brett-daley/Project-Amp/Images/Printed_Circuit_Board.jpg

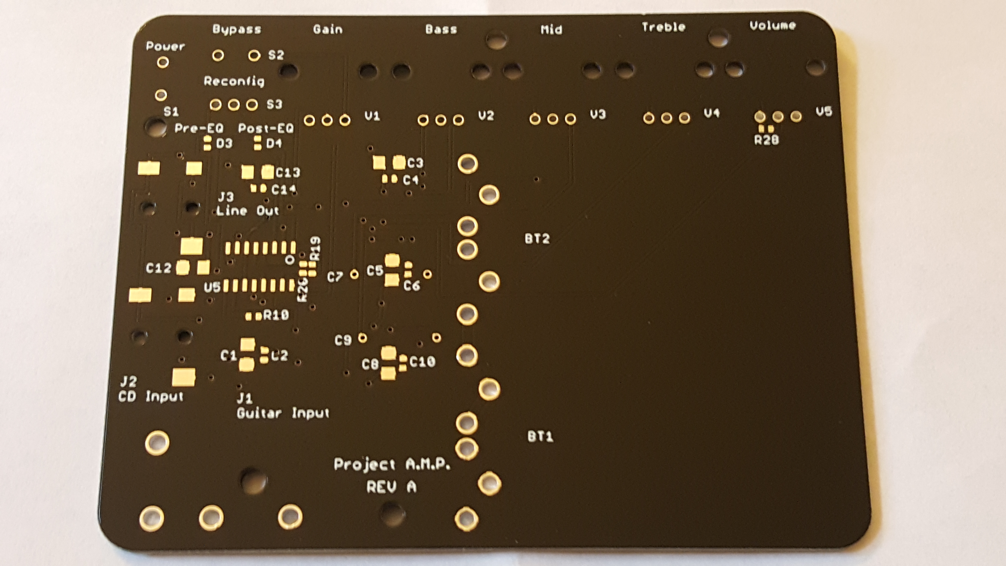
Images/Printed_Circuit_Board.jpg
