brett-daley/Project-Amp/Images/PCB_Assembly.png

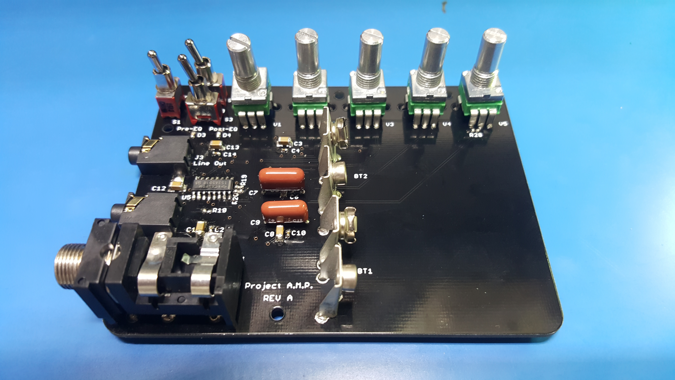
Images/PCB_Assembly.png
