brett-daley/Project-Amp/README.md

# Project-Amp
Small, portable headphone amplifier for the guitar. Complete with EQ and distortion.
