brett-daley/Project-Amp/Images/Layout_Bottom.png

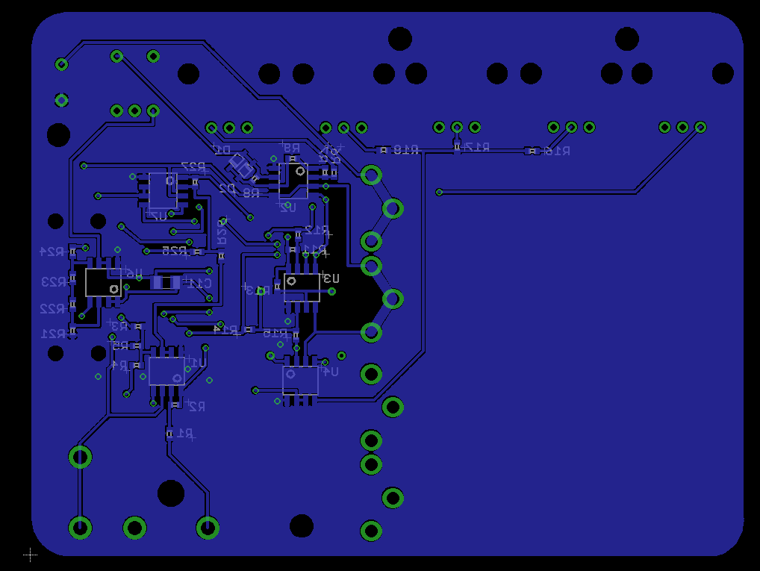
Images/Layout_Bottom.png
