brett-daley/Project-Amp/Images/Layout_Top.png

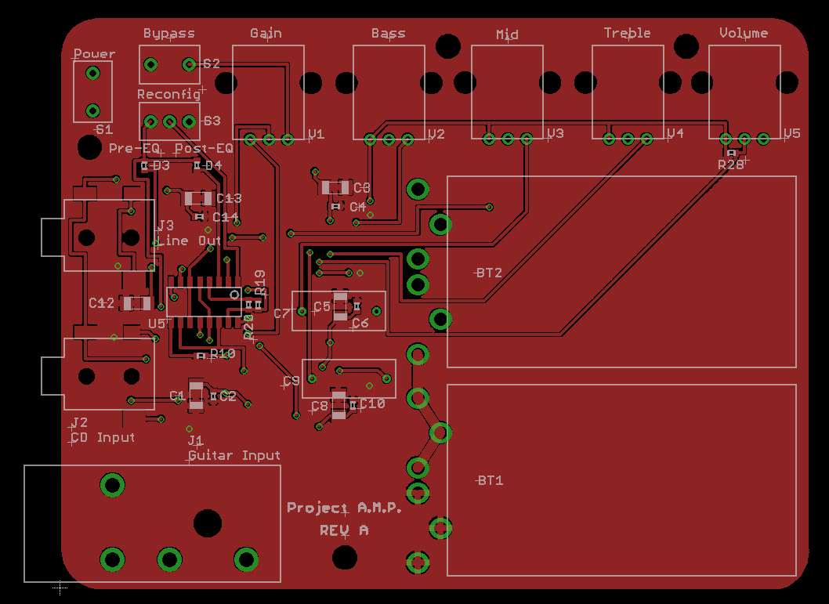
Images/Layout_Top.png
