brett-daley/Project-Amp/Images/Prototype1.jpg

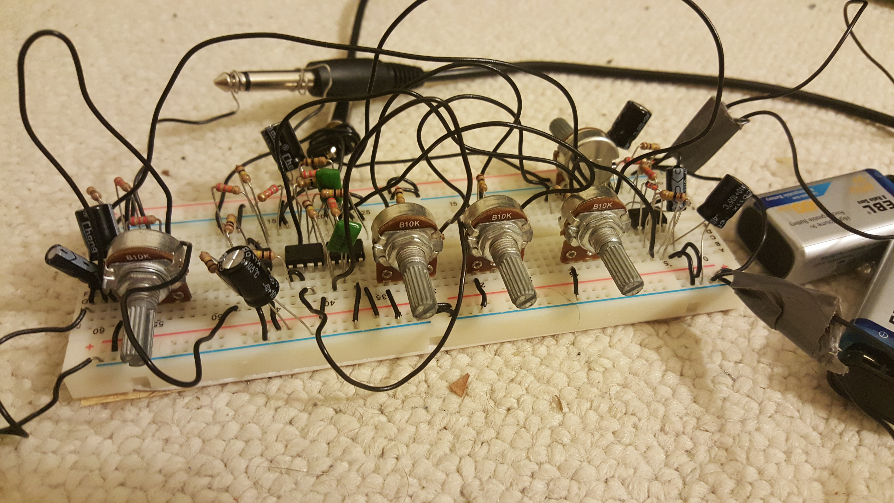
Images/Prototype1.jpg
