brett-daley/Project-Amp/Images/Prototype2.jpg

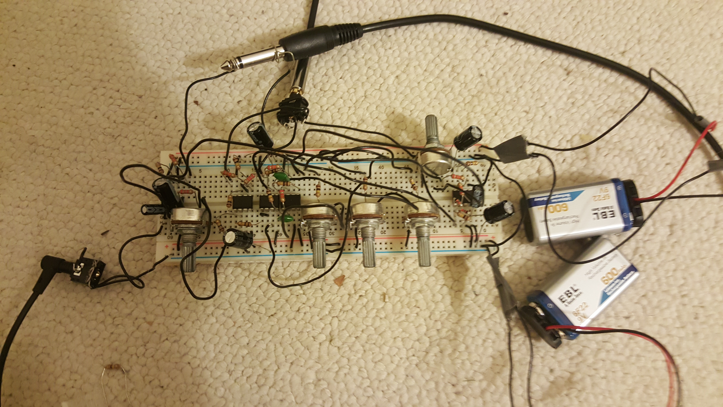
Images/Prototype2.jpg
