brett-daley/Project-Amp/Images/Schematics/EAGLE/1_Preamp.png

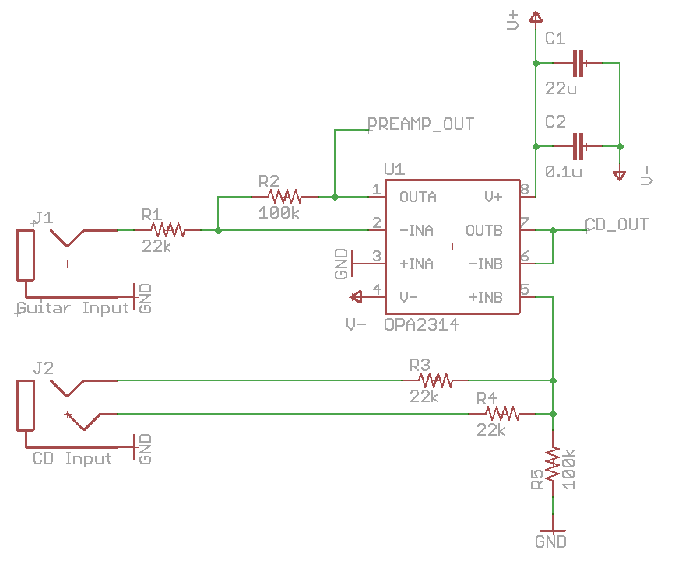
Images/Schematics/EAGLE/1_Preamp.png
