brett-daley/Project-Amp/Images/Schematics/EAGLE/2_Distortion.png

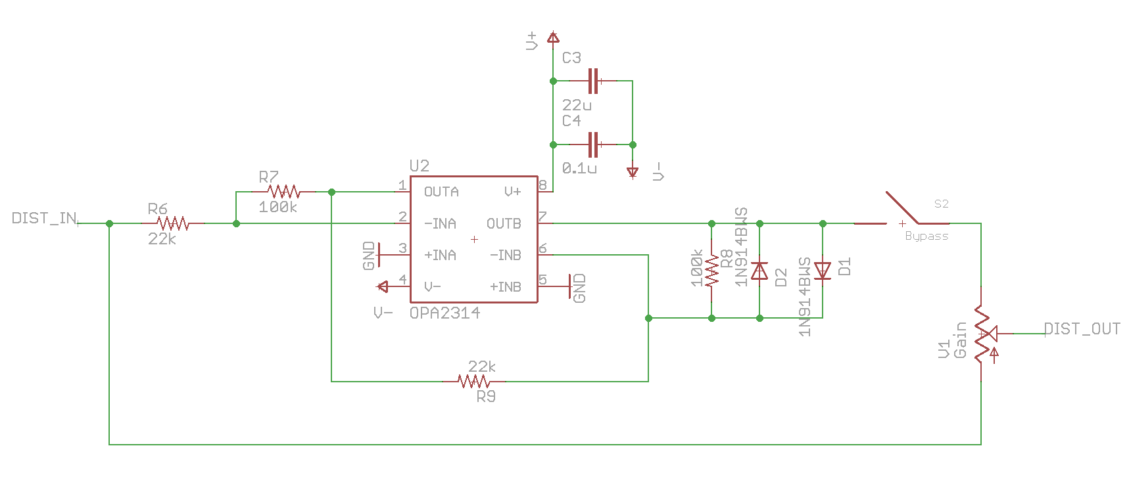
Images/Schematics/EAGLE/2_Distortion.png
