brett-daley/Project-Amp/Images/Schematics/EAGLE/3_Equalization.png

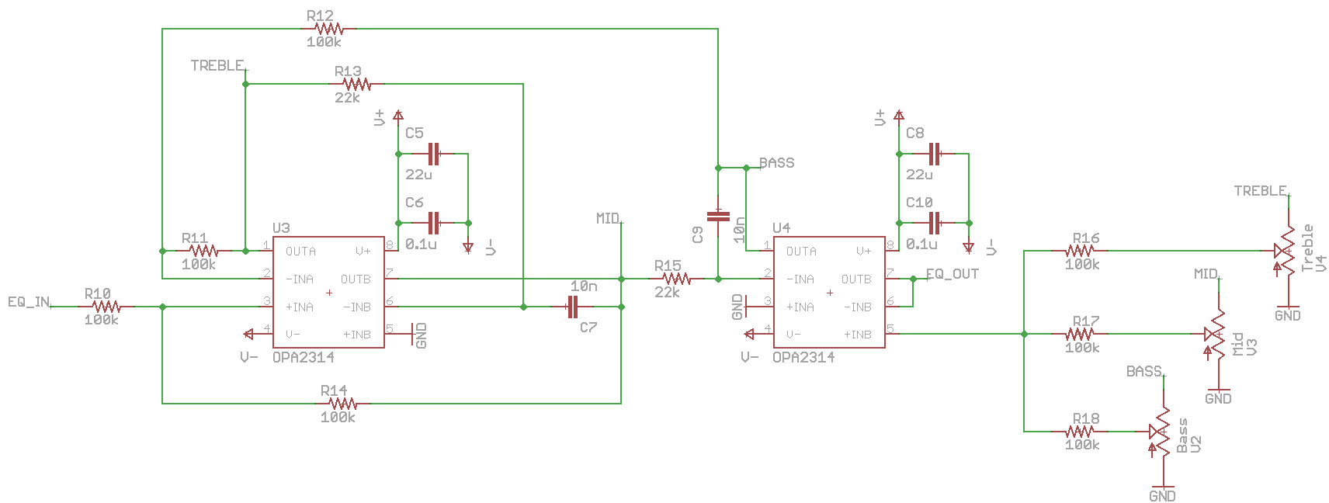
Images/Schematics/EAGLE/3_Equalization.png
