brett-daley/Project-Amp/Images/Schematics/EAGLE/4_Reconfig.png

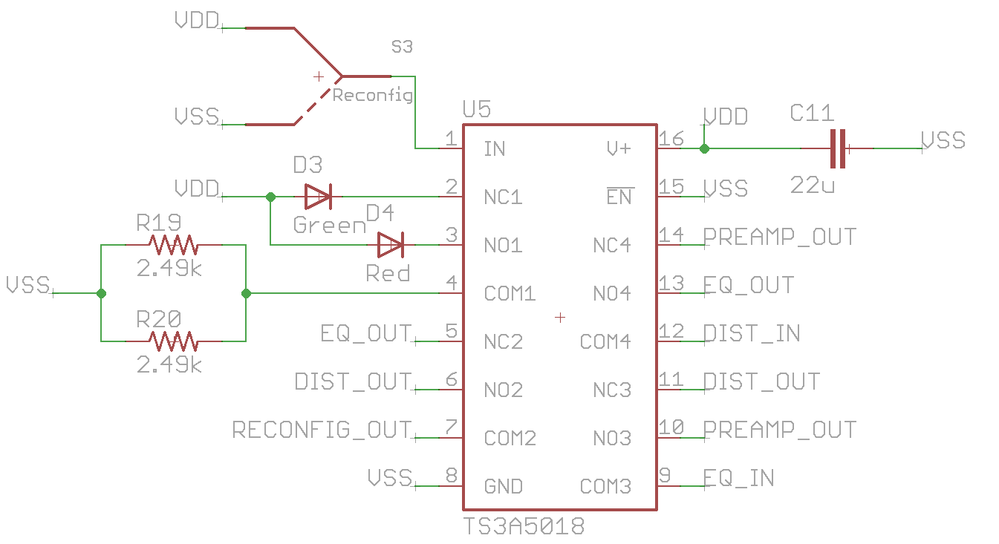
Images/Schematics/EAGLE/4_Reconfig.png
