brett-daley/Project-Amp/Images/Schematics/EAGLE/5_Output.png

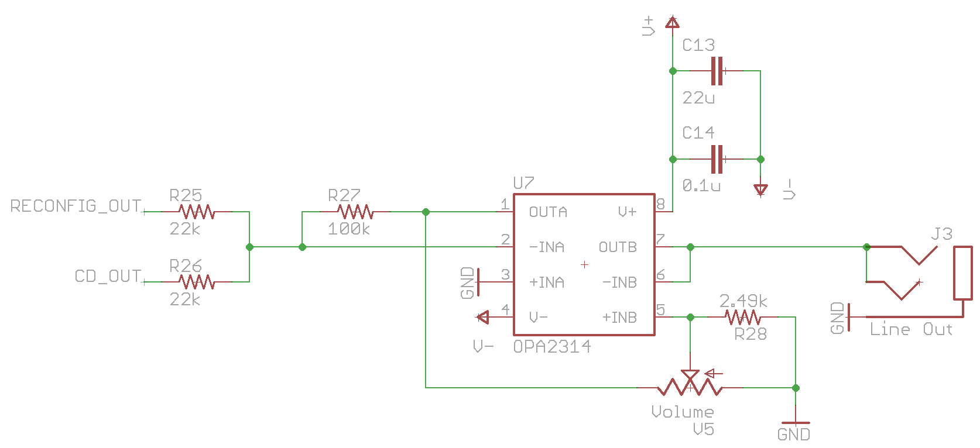
Images/Schematics/EAGLE/5_Output.png
