brett-daley/Project-Amp/Images/Schematics/EAGLE/6_Power_Supplies.png

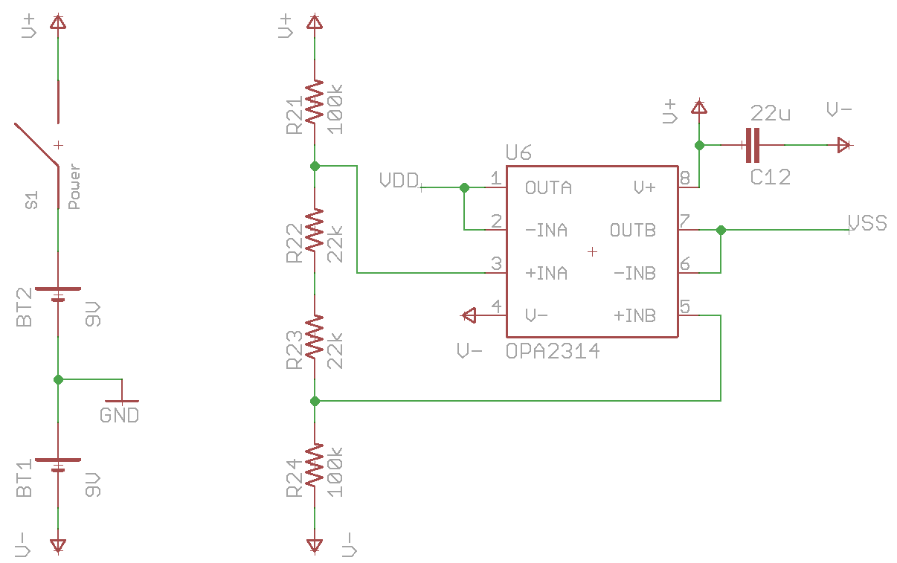
Images/Schematics/EAGLE/6_Power_Supplies.png
