brett-daley/Project-Amp/Images/Schematics/LTSpice/1_Preamp.png

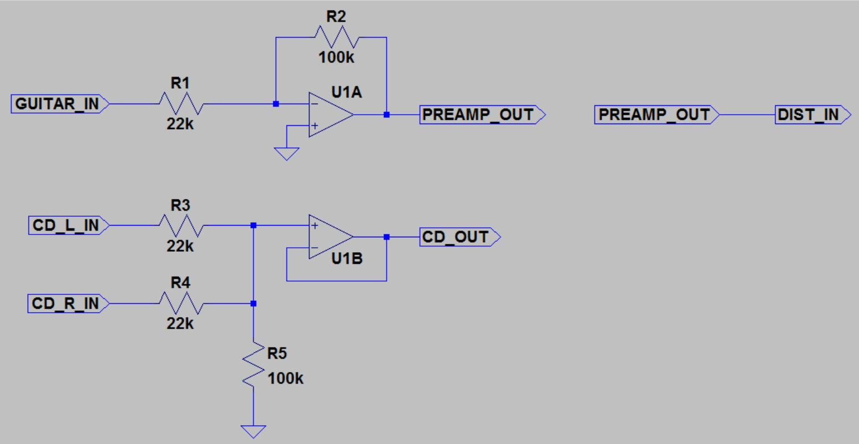
Images/Schematics/LTSpice/1_Preamp.png
