brett-daley/Project-Amp/Images/Schematics/LTSpice/2_Distortion.png

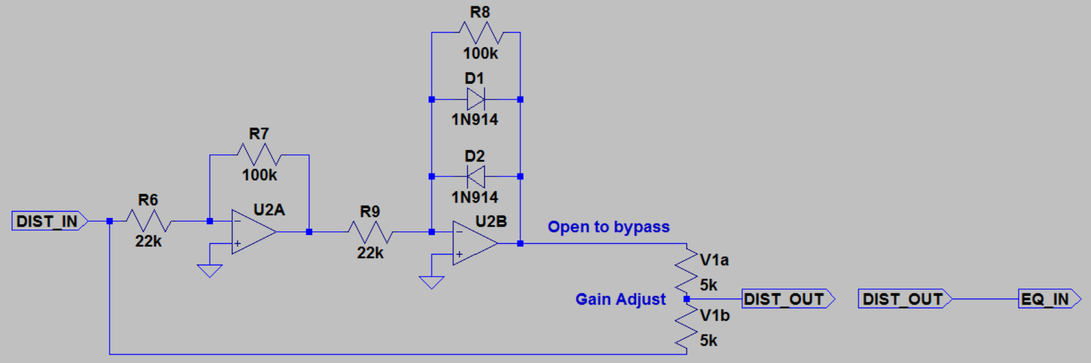
Images/Schematics/LTSpice/2_Distortion.png
