brett-daley/Project-Amp/Images/Schematics/LTSpice/3_Equalization.png

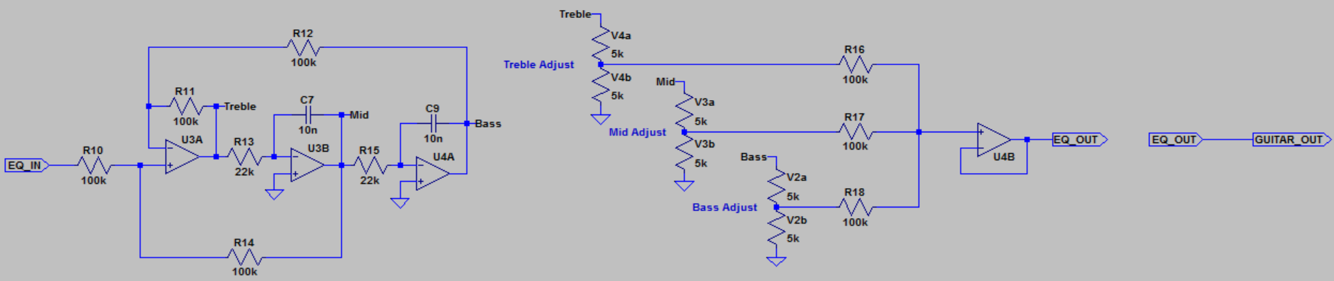
Images/Schematics/LTSpice/3_Equalization.png
