brett-daley/Project-Amp/Images/Schematics/LTSpice/4_Output.png

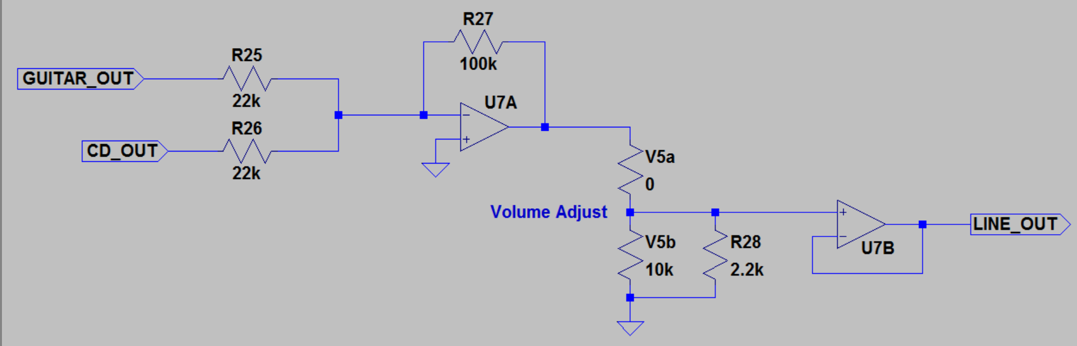
Images/Schematics/LTSpice/4_Output.png
