brett-daley/Project-Amp/Bill_Of_Materials_RevA.xlsx

Item | Reference | Description | Manufacturer | Manufacturer PN | Digi-Key PN | Quantity
1 | BT1,BT2 | CONN BATT MALE/FEM 9V HORZ SNAP-ON | Keystone Electronics | 593/594 | 36-593-ND/36-594-ND | 2
2 | C1,C3,C5,C8,C11,C12,C13 | 22µF 25V Ceramic Capacitor X5R 1206 (3216 Metric) 0.126" L x 0.063" W (3.20mm x 1.60mm) | Murata Electronics North America | GRM31CR61E226KE15L | 490-5527-2-ND | 7
3 | C2,C4,C6,C10,C14 | 0.10µF 25V Ceramic Capacitor X5R 0402 (1005 Metric) 0.039" L x 0.020" W (1.00mm x 0.50mm) | Murata Electronics North America | GRM155R61E104KA87D | 490-5920-1-ND | 5
4 | C7,C9 | 10000pF Film Capacitor 630V Polypropylene (PP), Metallized Radial 0.492" L x 0.205" W (12.50mm x 5.20mm) | Panasonic Electronic Components | ECW-F6103HL | P12109-ND | 2
5 | D1,D2 | DIODE GEN PURP 75V 150MA SOD323F | Fairchild Semiconductor | 1N914BWS | 1N914BWSCT-ND | 2
6 | D3 | Green 569nm LED Indication Discrete 1.9V Clear Lens 0402 (1005 Metric) | Rohm Semiconductor | SML-P11MTT86 | 511-1652-1-ND | 1
7 | D4 | Red 621nm LED Indication Discrete 1.8V Clear Lens 0402 (1005 Metric) | Rohm Semiconductor | SML-P11UTT86 | 511-1653-1-ND | 1
8 | J1 | 6.35mm (0.250", 1/4") - Headphone Phone Jack Stereo Connector Solder | Switchcraft Inc. | RA49C12B | SC2083-ND | 1
9 | J2,J3 | 3.50mm (0.141", 1/8", Mini Plug) - Headphone Phone Jack Stereo Connector Solder | CUI Inc. | SJ1-3513-SMT-TR | CP1-3513SJCT-ND | 2
10 | R1,R3,R4,R6,R9,R13,R15,R22,R23,R25,R26 | RES SMD 22K OHM 1% 1/16W 0402 | Yageo | RC0402FR-0722KL | 311-22.0KLRCT-ND | 11
11 | R2,R5,R7,R8,R10,R11,R12,R14,R16,R17,R18,R21,R24,R27 | RES SMD 100K OHM 1% 1/16W 0402 | Yageo | RC0402FR-07100KL | 311-100KLRCT-ND | 14
12 | R19,R20,R28 | RES SMD 2.49K OHM 1% 1/16W 0402 | Yageo | RC0402FR-072K49L | 311-2.49KLRCT-ND | 3
13 | S1,S2 | Toggle Switch SPST Through Hole | TE Connectivity Alcoswitch Switches | TMS6T5B2M2RE | 450-2110-ND | 2
14 | S3 | Toggle Switch SPDT Through Hole | TE Connectivity Alcoswitch Switches | TMS1T5B2M2RE | 450-2103-ND | 1
15 | U1,U2,U3,U4,U6,U7 | IC OPAMP AUDIO 8MHZ 8SOIC | Texas Instruments | OPA2134UA | OPA2134UA-ND | 6
16 | U5 | IC SWITCH QUAD SPDT 16SOIC | Texas Instruments | TS3A5018DR | 296-17611-1-ND | 1
17 | V1,V2,V3,V4,V5 | POT 10K OHM 1/20W PLASTIC LINEAR | TT Electronics/BI | P0915N-EC15BR10K | 987-1666-ND | 5
 |  |  |  |  | Total: | 66
