brett-daley/Project-Amp/LTSpice/Project_Amp_RevA.asc

C7: cap; 10n
C9: cap; 10n
CD_IN_LEFT: voltage; SINE(0 0m 1000 0 0 30)
CD_IN_RIGHT: voltage; SINE(0 0m 1000 0 0 30)
D1: diode; 1N914
D2: diode; 1N914
GUITAR: voltage; SINE(0 100m 440); AC 1
R1: res; 22k
R2: res; 100k
R3: res; 22k
R4: res; 22k
R5: res; 100k
R6: res; 22k
R7: res; 100k
R8: res; 100k
R9: res; 22k
R10: res; 100k
R11: res; 100k
R12: res; 100k
R13: res; 22k
R14: res; 100k
R15: res; 22k
R16: res; 100k
R17: res; 100k
R18: res; 100k
R25: res; 22k
R26: res; 22k
R27: res; 100k
R28: res; 2.2k
U1A: opamp
U1B: opamp
U2A: opamp
U2B: opamp
U3A: opamp
U3B: opamp
U4A: opamp
U4B: opamp
U7A: opamp
U7B: opamp
V1a: res; 5k
V1b: res; 5k
V2a: res; 5k
V2b: res; 5k
V3a: res; 5k
V3b: res; 5k
V4a: res; 5k
V4b: res; 5k
V5a: res; 0
V5b: res; 10k
Named nets: 0, LINE_OUT, DIST_IN, DIST_OUT, PREAMP_OUT, Treble, Mid, Bass, EQ_IN, EQ_OUT, GUITAR_OUT, GUITAR_IN, CD_L_IN, CD_R_IN, CD_OUT
.lib opamp.sub
Volume Adjust
.tran 12m
Open to bypass
Gain Adjust
Treble Adjust
Mid Adjust
Bass Adjust
