brett-daley/Project-Amp/EAGLE/Project_Amp_RevA.brd

## EAGLE design EAGLE/Project_Amp_RevA.brd (2016-08-25)

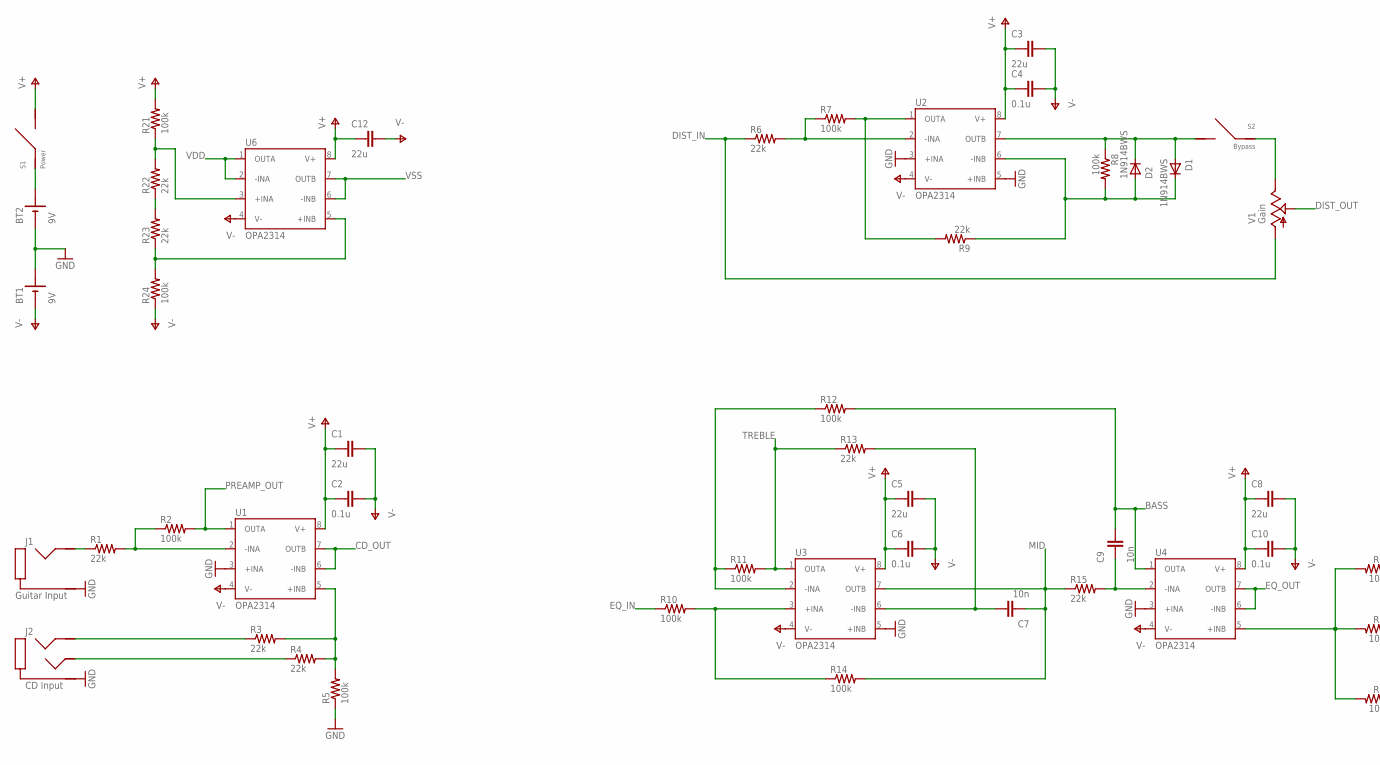
[picture p17: schematic Project_Amp_RevA.sch, part in row 1, column 1]

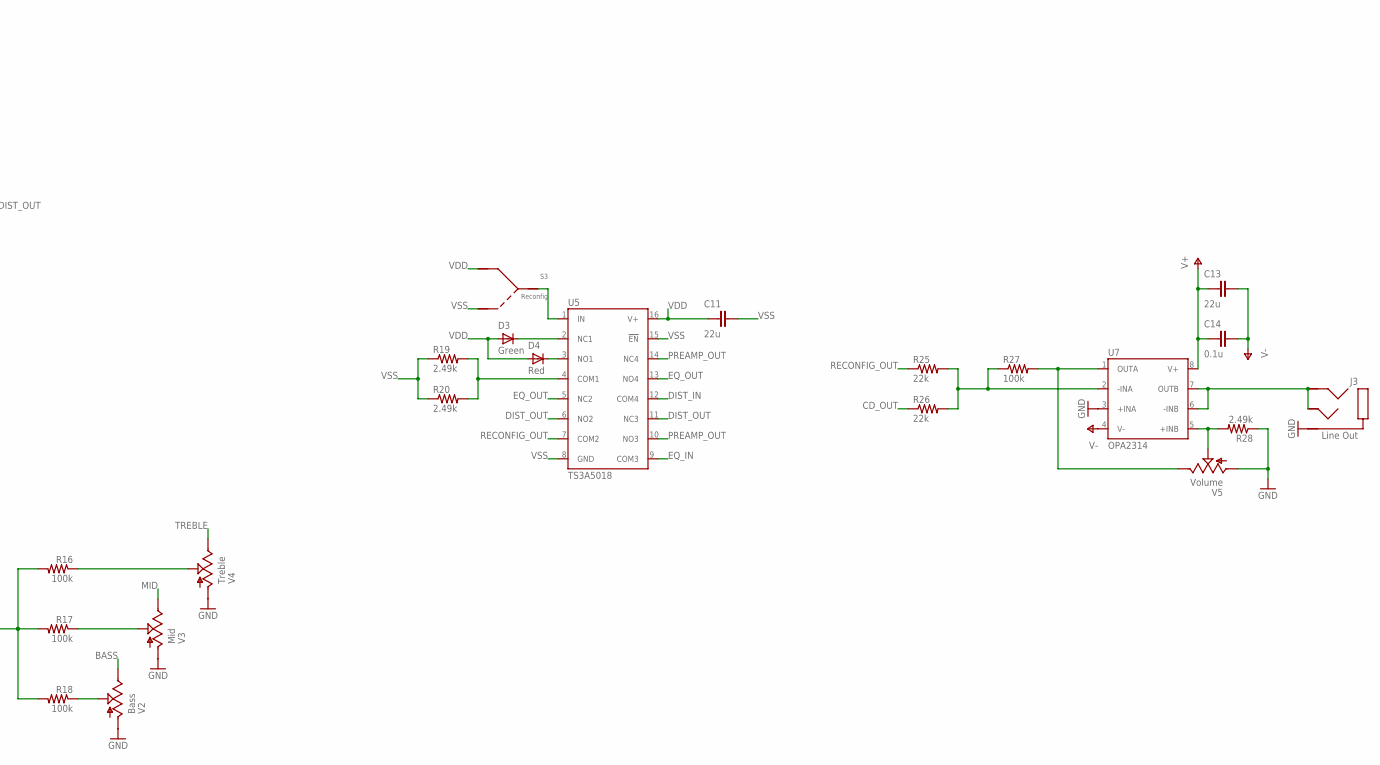
[picture p18: schematic Project_Amp_RevA.sch, part in row 1, column 2]

Parts:
BT1, BT2: 9V; 9V59X
C1, C3, C5, C8, C11, C12, C13: 22u; C1206
C2, C4, C6, C10, C14: 0.1u; C0402
C7, C9: 10n; ECW-F6103HL
D1, D2: 1N914BWS; SOD-323F
D3: Green; R0402
D4: Red; R0402
J1: Guitar Input; RA49C12B
J2: CD Input; SJ1-3513-SMT-TR
J3: Line Out; SJ1-3513-SMT-TR
R1, R3, R4, R6, R9, R13, R15, R22, R23, R25, R26: 22k; R0402
R2, R5, R7, R8, R10, R11, R12, R14, R16, R17, R18, R21, R24, R27: 100k; R0402
R19, R20, R28: 2.49k; R0402
S1: Power; TMS6T5B2M2RE
S2: Bypass; TMS6T5B2M2RE
S3: Reconfig; TMS1T5B2M2R
U1, U2, U3, U4, U6, U7: OPA2314; 8-SOIC
U5: TS3A5018; 16-SOIC
V1: Gain; P0915N-EC15BR10K
V2: Bass; P0915N-EC15BR10K
V3: Mid; P0915N-EC15BR10K
V4: Treble; P0915N-EC15BR10K
V5: Volume; P0915N-EC15BR10K

Connections:
BASS: C9.1, R12.2, U4.1 (OUTA), V2.3 (E)
CD_OUT: R26.1, U1.6 (-INB), U1.7 (OUTB)
DIST_IN: R6.1, U5.12 (COM4), V1.1 (A)
DIST_OUT: U5.6 (NO2), U5.11 (NC3), V1.2 (S)
EQ_IN: R10.1, U5.9 (COM3)
EQ_OUT: U4.6 (-INB), U4.7 (OUTB), U5.5 (NC2), U5.13 (NO4)
GND: BT1.4 (+), BT1.5 (+), BT1.6 (+), BT2.1 (-), BT2.2 (-), BT2.3 (-), J1.S1 (COM), J1.S2 (COM), J2.1 (COM), J3.1 (COM), R5.1, R28.1, U1.3 (+INA), U2.3 (+INA), U2.5 (+INB), U3.5 (+INB), U4.3 (+INA), U7.3 (+INA), V2.1 (A), V3.1 (A), V4.1 (A), V5.1 (A)
LINE_OUT: J3.2 (LEFT), J3.3 (RIGHT), U7.6 (-INB), U7.7 (OUTB)
MID: C7.2, R14.2, R15.1, U3.7 (OUTB), V3.3 (E)
unnamed: R21.1, R22.2, U6.3 (+INA)
unnamed: J1.T (SIG), R1.1
unnamed: R1.2, R2.1, U1.2 (-INA)
unnamed: R3.2, R4.2, R5.2, U1.5 (+INB)
unnamed: R22.1, R23.2
unnamed: J2.2 (LEFT), R4.1
unnamed: J2.3 (RIGHT), R3.1
unnamed: R23.1, R24.2, U6.5 (+INB)
unnamed: D3.2 (C), U5.2 (NC1)
unnamed: R19.2, R20.2, U5.4 (COM1)
unnamed: D1.2 (A), D2.1 (C), R8.1, S2.1, U2.7 (OUTB)
unnamed: D1.1 (C), D2.2 (A), R8.2, R9.1, U2.6 (-INB)
unnamed: R7.2, R9.2, U2.1 (OUTA)
unnamed: R6.2, R7.1, U2.2 (-INA)
unnamed: S2.3, V1.3 (E)
unnamed: R16.2, R17.2, R18.2, U4.5 (+INB)
unnamed: R16.1, V4.2 (S)
unnamed: R17.1, V3.2 (S)
unnamed: R18.1, V2.2 (S)
unnamed: R10.2, R14.1, U3.3 (+INA)
unnamed: R11.1, R12.1, U3.2 (-INA)
unnamed: C7.1, R13.2, U3.6 (-INB)
unnamed: C9.2, R15.2, U4.2 (-INA)
unnamed: R27.2, U7.1 (OUTA), V5.3 (E)
unnamed: R25.2, R26.2, R27.1, U7.2 (-INA)
unnamed: R28.2, U7.5 (+INB), V5.2 (S)
unnamed: BT2.4 (+), BT2.5 (+), BT2.6 (+), S1.3
unnamed: S3.2 (COM), U5.1 (IN)
unnamed: D4.2 (C), U5.3 (NO1)
PREAMP_OUT: R2.2, U1.1 (OUTA), U5.10 (NO3), U5.14 (NC4)
RECONFIG_OUT: R25.1, U5.7 (COM2)
TREBLE: R11.2, R13.1, U3.1 (OUTA), V4.3 (E)
V+: C1.2, C2.2, C3.2, C4.2, C5.2, C6.2, C8.2, C10.2, C12.2, C13.2, C14.2, R21.2, S1.1, U1.8 (V+), U2.8 (V+), U3.8 (V+), U4.8 (V+), U6.8 (V+), U7.8 (V+)
V-: BT1.1 (-), BT1.2 (-), BT1.3 (-), C1.1, C2.1, C3.1, C4.1, C5.1, C6.1, C8.1, C10.1, C12.1, C13.1, C14.1, R24.1, U1.4 (V-), U2.4 (V-), U3.4 (V-), U4.4 (V-), U6.4 (V-), U7.4 (V-)
VDD: C11.2, D3.1 (A), D4.1 (A), S3.3 (POS1), U5.16 (V+), U6.1 (OUTA), U6.2 (-INA)
VSS: C11.1, R19.1, R20.1, S3.1 (POS2), U5.8 (GND), U5.15 (!EN), U6.6 (-INB), U6.7 (OUTB)

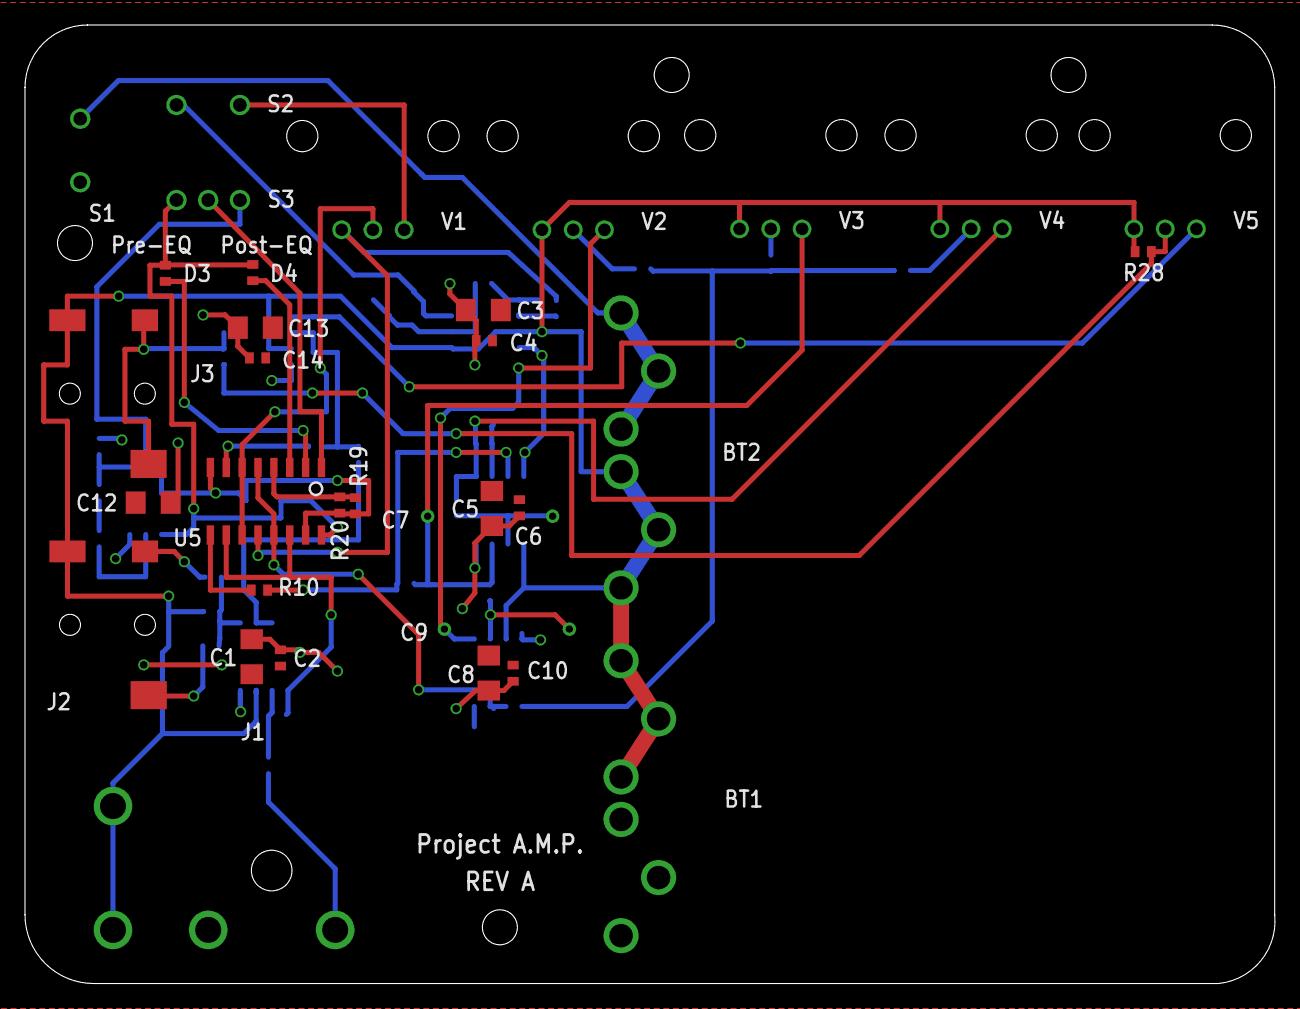
[picture p19: board Project_Amp_RevA.brd from above]

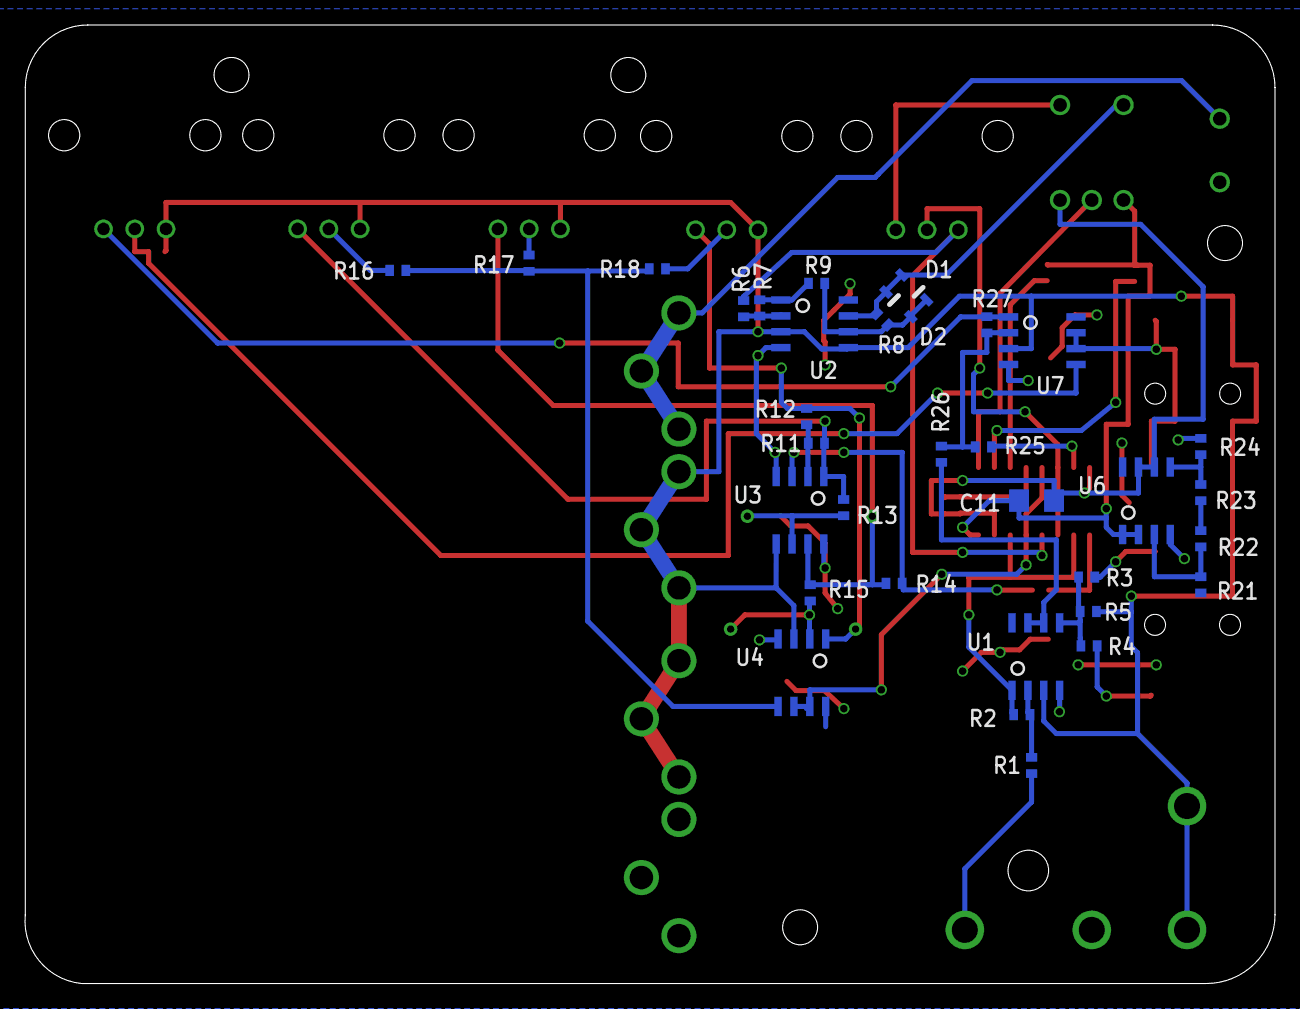
[picture p20: board Project_Amp_RevA.brd from below]

Board: 2 copper layers, 100.0 x 76.7 mm, 66 parts (33 on the bottom side), 45 nets.
