brett-daley/Project-Amp/(commit log)

2016-06-19 Add files via upload
    Added custom Eagle library, schematics, board file, and Gerbers
    [Amplifier.brd, Amplifier.sch]
2016-08-25 Restructure directories, upload images, include BOM
    [Bill_Of_Materials.xlsx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]
2016-08-25 Include EAGLE project files
    [Project_Amp_RevA.brd, Project_Amp_RevA.sch]
2016-08-25 Fix error in page 2 of EAGLE schematics
2016-08-25 Reorganize schematics and EAGLE project files
    [Project_Amp_RevA.brd, Project_Amp_RevA.sch]
2016-10-17 Add revision to BOM
    [Bill_Of_Materials_RevA.xlsx]
